IKGB105/EFUSE-LTC4215-HotSwap/fem/figuras/15A_acercamiento_R5_Q1.png

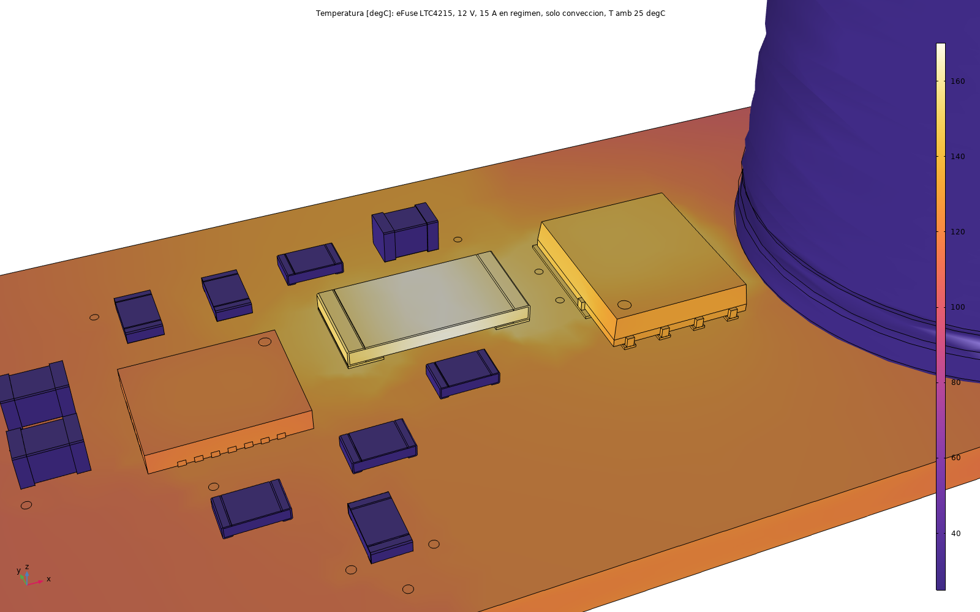
fem/figuras/15A_acercamiento_R5_Q1.png
