IKGB105/EFUSE-LTC4215-HotSwap/fem/figuras/15A_superior.png

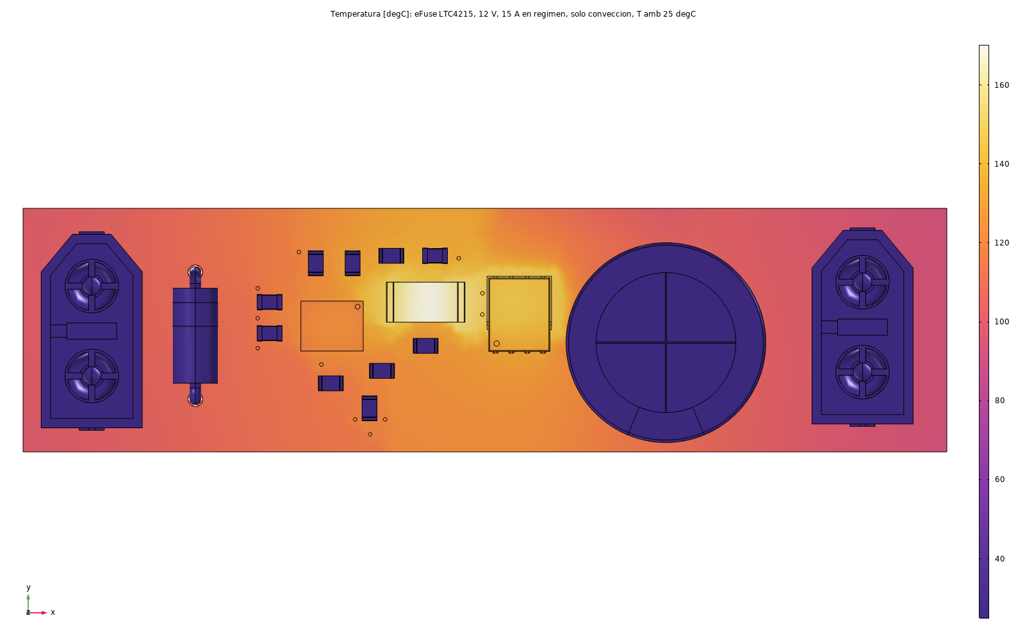
fem/figuras/15A_superior.png
