IKGB105/EFUSE-LTC4215-HotSwap/fem/geometria/EFUSE.step

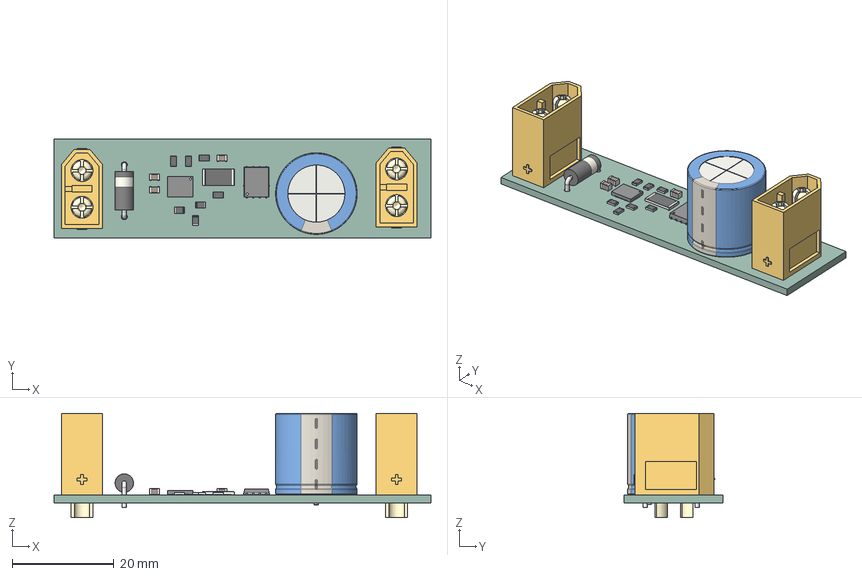
[picture p8: CAD file, 2026-10-28]
fem/geometria/EFUSE.step
74.0 x 19.5 x 20.5 mm
C_0805_2012Metric x 3
R_2512_6332Metric
CP_Radial_D160mm_P750mm
XT60 male v9 x 2
R_0805_2012Metric x 7
D_DO-15_P10.16mm_Horizontal
SIR826ADP-T1-GE3
LTC4306IUFD#TRPBF
EFUSE_PCB
