IKGB105/EFUSE-LTC4215-HotSwap/(list of files, cad)

Other CAD files:
fem/geometria/sin_vias/EFUSE.step
