IKGB105/EFUSE-LTC4215-HotSwap/fem/resultados/barrido_corriente.csv

I [A] | P_R5 [W] | P_Q1 [W] | P_tot [W] | T max R5 [degC] | T union Q1 (cara pad-cuerpo) [degC] | T max Q1 [degC] | T max U1 [degC] | T max placa [degC]
5 | 0.125 | 0.060 | 0.221 | 45.7 | 43.2 | 43.2 | 41.8 | 44.3
7.5 | 0.281 | 0.135 | 0.452 | 66.1 | 60.6 | 60.6 | 56.1 | 63.0
10 | 0.500 | 0.240 | 0.776 | 93.5 | 83.9 | 83.9 | 74.8 | 88.0
12.5 | 0.781 | 0.375 | 1.192 | 127.9 | 113.0 | 113.0 | 98.2 | 119.4
15 | 1.125 | 0.540 | 1.701 | 170.2 | 148.9 | 149.0 | 126.8 | 158.0
