IKGB105/EFUSE-LTC4215-HotSwap/fem/resultados/variantes_15A.csv

variante | P_Q1 [W] | T max R5 [degC] | T union Q1 (cara pad-cuerpo) [degC] | T max Q1 [degC] | T max U1 [degC] | T max placa [degC]
Rds(on) a 25 degC, solo conveccion (base) | 0.540 | 170.2 | 148.9 | 149.0 | 126.8 | 158.0
Rds(on) x1.5 (caliente), solo conveccion | 0.810 | 180.7 | 163.9 | 163.9 | 133.6 | 170.1
Rds(on) a 25 degC + radiacion (eps 0.9) | 0.540 | 133.3 | 112.3 | 112.4 | 91.3 | 121.2
Rds(on) x1.5 + radiacion | 0.810 | 140.6 | 124.1 | 124.1 | 95.3 | 130.1
