IKGB105/EFUSE-LTC4215-HotSwap/fem/resultados/sin_calentamiento_cobre/barrido_corriente.csv

I [A] | P_R5 [W] | P_Q1 [W] | P_tot [W] | T max R5 [degC] | T union Q1 (cara pad-cuerpo) [degC] | T max Q1 [degC] | T max U1 [degC] | T max placa [degC]
5 | 0.125 | 0.060 | 0.221 | 41.9 | 39.5 | 39.5 | 37.0 | 40.5
7.5 | 0.281 | 0.135 | 0.452 | 58.2 | 53.0 | 53.0 | 46.0 | 55.3
10 | 0.500 | 0.240 | 0.776 | 79.8 | 70.8 | 70.8 | 57.5 | 74.7
12.5 | 0.781 | 0.375 | 1.192 | 107.1 | 92.8 | 92.8 | 71.2 | 99.0
15 | 1.125 | 0.540 | 1.701 | 139.1 | 118.7 | 118.8 | 87.1 | 127.8
