IKGB105/EFUSE-LTC4215-HotSwap/fem/resultados/sin_vias_con_joule/barrido_corriente.csv

I [A] | P_R5 [W] | P_Q1 [W] | P_tot [W] | T max R5 [degC] | T union Q1 (cara pad-cuerpo) [degC] | T max Q1 [degC] | T max U1 [degC] | T max placa [degC]
5 | 0.125 | 0.060 | 0.221 | 46.7 | 44.4 | 44.4 | 41.9 | 45.5
7.5 | 0.281 | 0.135 | 0.452 | 68.3 | 63.2 | 63.2 | 56.2 | 65.6
10 | 0.500 | 0.240 | 0.776 | 97.4 | 88.4 | 88.4 | 75.1 | 92.5
12.5 | 0.781 | 0.375 | 1.192 | 133.9 | 119.9 | 120.0 | 98.5 | 126.4
15 | 1.125 | 0.540 | 1.701 | 178.9 | 158.7 | 158.8 | 127.2 | 168.0
