IKGB105/EFUSE-LTC4215-HotSwap/simulation/EFuse.asc

C1: cap; 68n
C2: cap; 3.3µ
C3: cap; 0.1µ
C4: cap; 12m
D1: zener; BZX84C15L
M1: nmos; Si7336ADP
R1: res; 10
R2: res; 24k
R3: res; 3.4k
R4: res; 1.18k
R5: res; 34.8k
R6: res; 0.005
R7: res; 30.1k
R8: res; 3.57k
S1: sw; SWMOD
U1: LTC4215
V1: voltage; PWL(0 0 1u 12 300m 12 300.001m 8 320m 8 320.001m 12 400m 12)
V2: voltage; PULSE(0 5 550m 1u 1u 150m 1)
Named nets: 0, INTVcc, Timer, Vout
.tran 700m
.model SWMOD SW(Ron=10m Roff=1Meg Vt=2.5 Vh=0.5)
