IKGB105/EFUSE-LTC4215-HotSwap/kicad/EFUSE/EFUSE.kicad_pcb

## KiCad design kicad/EFUSE/EFUSE.kicad_pcb (2026-10-28)

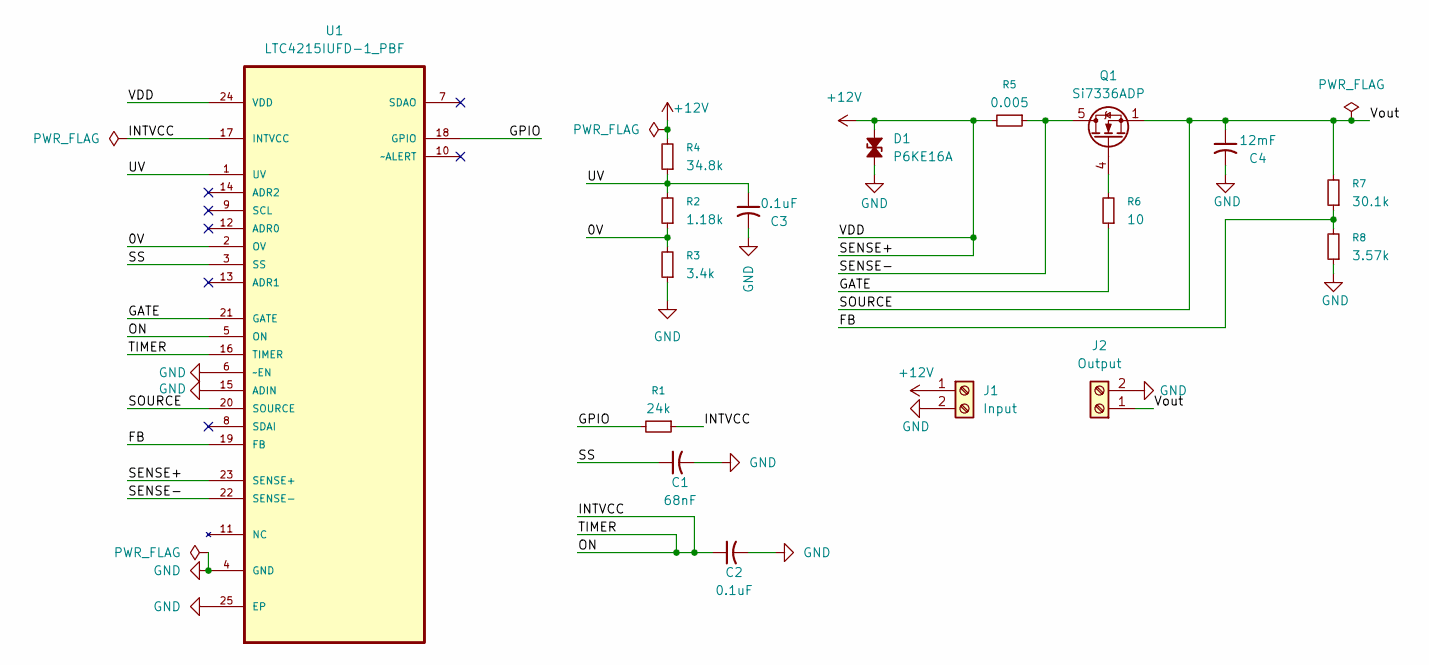
[picture p9: schematic EFUSE.kicad_sch, EFUSE-LTC4215IUFD]

Parts:
C1: 68nF; C_0805_2012Metric
C2, C3: 0.1uF; C_0805_2012Metric
C4: 12mF; CP_Radial_D16.0mm_P7.50mm
D1: P6KE16A; D_DO-15_P10.16mm_Horizontal
J1: Input; AMASS_XT60-M_1x02_P7.20mm_Vertical
J2: Output; AMASS_XT60-M_1x02_P7.20mm_Vertical
Q1: Si7336ADP; PowerPAK_SO-8_Single
R1: 24k; R_0805_2012Metric
R2: 1.18k; R_0805_2012Metric
R3: 3.4k; R_0805_2012Metric
R4: 34.8k; R_0805_2012Metric
R5: 0.005; R_2512_6332Metric
R6: 10; R_0805_2012Metric
R7: 30.1k; R_0805_2012Metric
R8: 3.57k; R_0805_2012Metric
U1: LTC4215IUFD-1_PBF; QFN50P400X500X80-25N; MPN LTC4215IUFD-2#TRPBF; DigiKey_Part_Number LTC4215IUFD-1#PBF-ND

Connections:
+12V: D1.1 (A1), J1.1, R4.2, R5.2, U1.23 (SENSE+), U1.24 (VDD)
/0V: R2.1, R3.2, U1.2 (OV)
/FB: R7.1, R8.2, U1.19 (FB)
/GATE: R6.1, U1.21 (GATE)
/GPIO: R1.2, U1.18 (GPIO)
/INTVCC: C2.1, R1.1, U1.5 (ON), U1.16 (TIMER), U1.17 (INTVCC)
/SENSE-: Q1.5 (D), R5.1, U1.22 (SENSE-)
/SOURCE: C4.1, J2.1, Q1.1 (S), Q1.2 (S), Q1.3 (S), R7.2, U1.20 (SOURCE)
/SS: C1.1, U1.3 (SS)
/UV: C3.1, R2.2, R4.1, U1.1 (UV)
GND: C1.2, C2.2, C3.2, C4.2, D1.2 (A2), J1.2, J2.2, R3.1, R8.1, U1.4 (GND), U1.6 (~EN), U1.15 (ADIN), U1.25 (EP)
unnamed: Q1.4 (G), R6.2

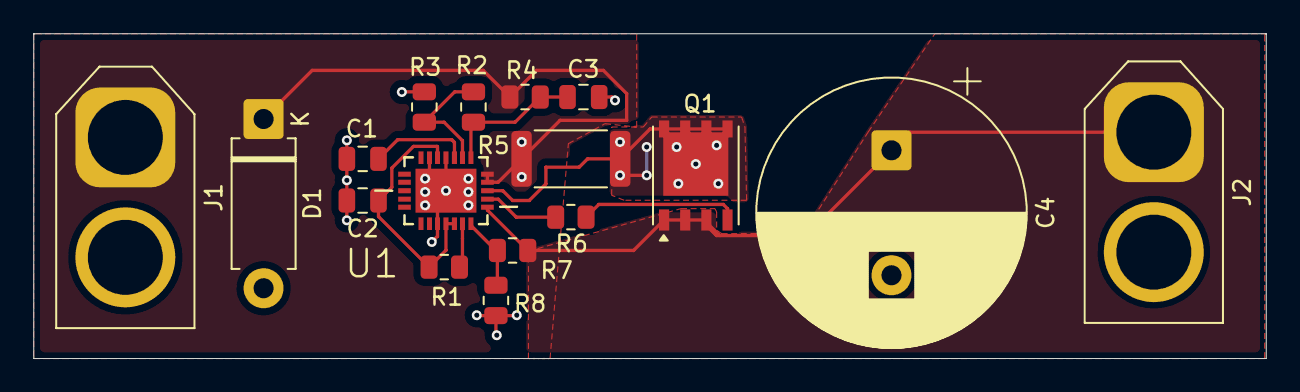
[picture p10: board EFUSE.kicad_pcb from above]

Board: 2 copper layers, 74.0 x 19.5 mm, 17 parts (0 on the bottom side), 12 nets.
