IKGB105/EFUSE-LTC4215-HotSwap/(commit log)

2026-10-28 Hot-swap eFuse (LTC4215): LTspice sim, KiCad schematic/PCB, COMSOL thermal FEM
    12V hot-swap/eFuse front-end: controlled startup, UV auto-retry, and OC
    latch-off validated in LTspice; ERC/DRC-clean QFN-24 schematic and 2-layer
    PCB in KiCad; coupled electrical-thermal COMSOL model found the copper
    pours dissipate as much heat as the components themselves, limiting safe
    continuous current to ~12.5A rather than the electrical 15A rating.
2026-10-28 Add schematic/PCB 3D renders and figure table to README
    Exported via kicad-cli (sch export svg, pcb render) to match the figure
    table style used in the other projects in this series.
2026-10-28 Crop schematic figure to remove empty bottom half
